IJMOK/eBus-Heating/enclosure/box-closed.png

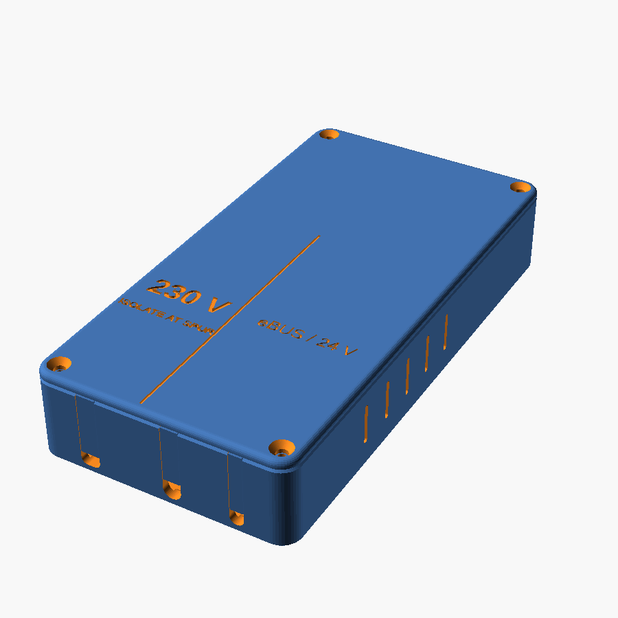
enclosure/box-closed.png
