IJMOK/eBus-Heating/enclosure/box-inside.png

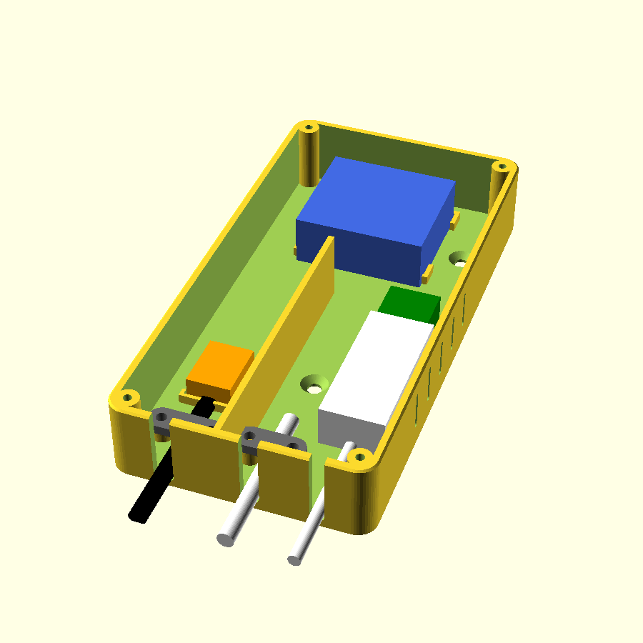
enclosure/box-inside.png
