IJMOK/eBus-Heating/enclosure/stl/clamp_mains.stl

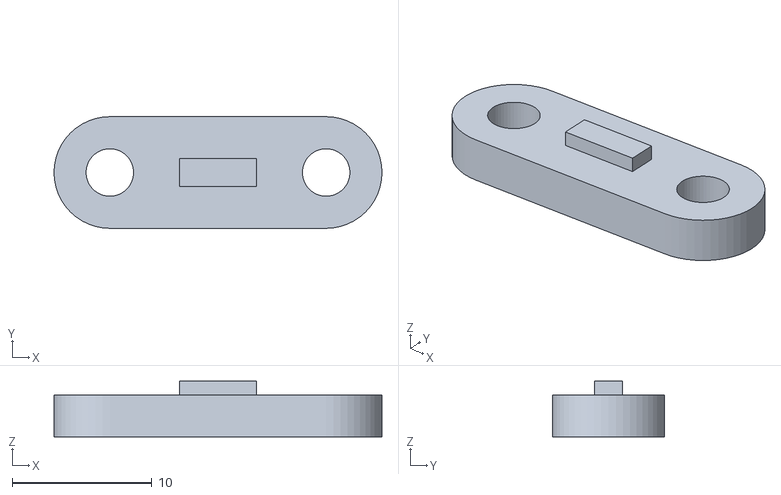
[picture p3: CAD file, 2026-10-21]
enclosure/stl/clamp_mains.stl
23.5 x 8.00 x 4.00
