IJMOK/eBus-Heating/enclosure/stl/testfit.stl

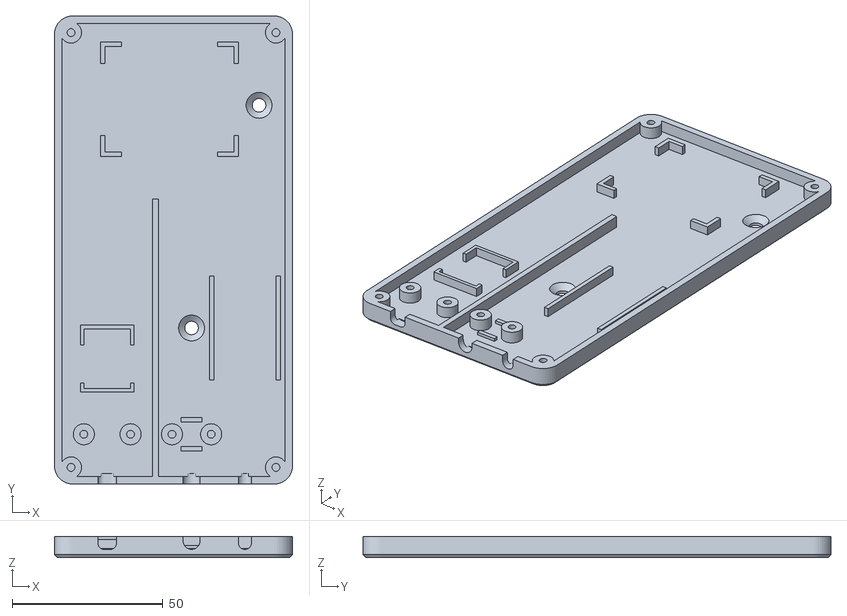
[picture p4: CAD file, 2026-10-21]
enclosure/stl/testfit.stl
79.0 x 155.3 x 7.00
