IJMOK/eBus-Heating/enclosure/stl/base.stl

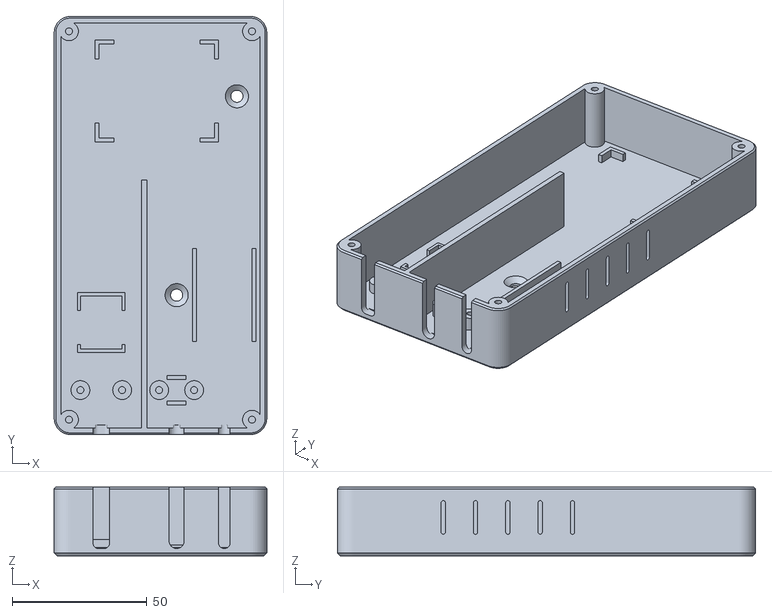
[picture p5: CAD file, 2026-10-21]
enclosure/stl/base.stl
79.0 x 155.3 x 25.5
