IJMOK/eBus-Heating/enclosure/stl/lid.stl

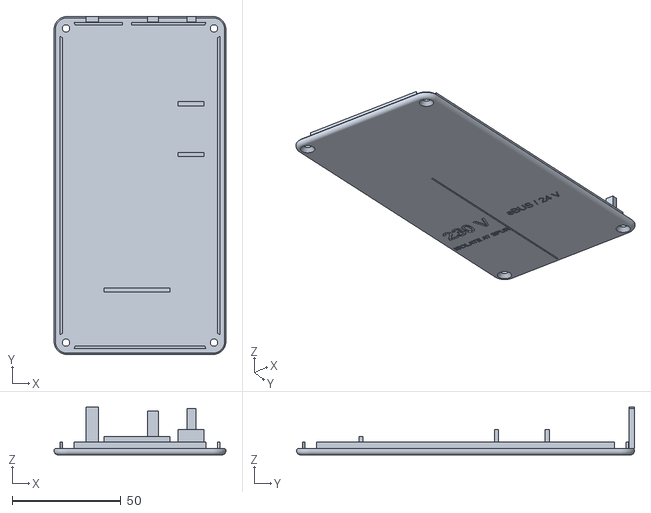
[picture p6: CAD file, 2026-10-21]
enclosure/stl/lid.stl
79.0 x 155.3 x 21.9
