IJMOK/eBus-Heating/enclosure/stl/clamp_lv.stl

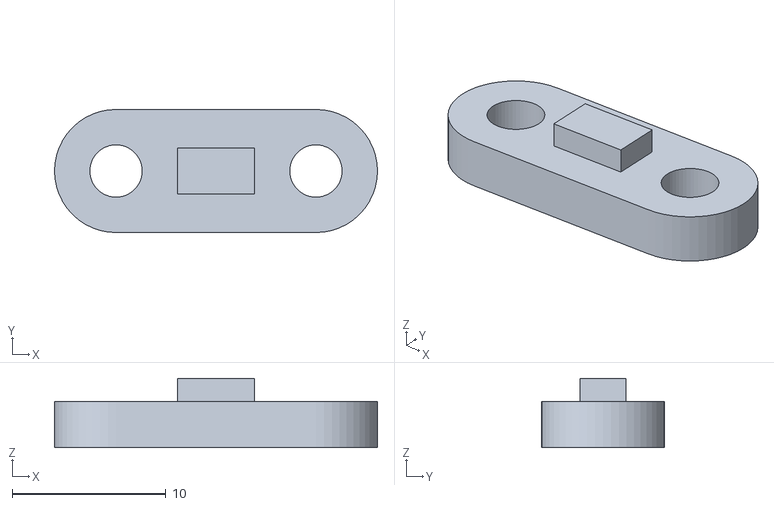
[picture p7: CAD file, 2026-10-21]
enclosure/stl/clamp_lv.stl
21.0 x 8.00 x 4.50
