IJMOK/eBus-Heating/docs/results.md

# Results

> Written during P7: stage history, comfort events, and the final learned curve.
