IJMOK/eBus-Heating/(commit log)

2026-10-16 P1 docs: eBUS stick firmware/Wi-Fi, wiring and safety, ebusd add-on setup (read-only)
2026-10-17 Helpers package, Node-RED flows (control, comfort, nightly) and dashboard: sanitised, dry-run by default
2026-10-17 Docs: hardware, Shelly failsafe, control law, staged handover, dashboard, test plan; failsafe script; heartbeat + eBUS watchdog flows
2026-10-17 Wiring: step-by-step Shelly 1 Gen4 to 24V RT, label reading, spur power
2026-10-17 Flows: unique node names
2026-10-18 Room sensor counts as stale after 90 min without a temperature or humidity update
    HA only records a reading when the value changes, so a steady room went quiet
    for 30+ minutes and looked like a dead sensor. The Shelly failsafe still
    catches a really dead sensor after 30 min.
2026-10-18 P5 failsafe test results (all 11 pass) and fixes
    - Shelly script re-publishes its mode on every MQTT (re)connect
    - Control law re-sends the relay state every 5 min
    - Button triggers accept a previous state of 'unknown'
    - Dashboard comfort tile presses the button instead of 'toggle'
    - eBUS-lost text mentions the bus-signal trigger
    [heating.yaml]
2026-10-18 Failsafe mode reaches HA without Node-RED (webhook)
    The Shelly script POSTs each mode change to an HA webhook (URL in KVS
    fs_webhook) and retries every minute until accepted. Package: webhook
    automation + one notify-on-change automation; the Node-RED mirror no longer
    notifies. Docs and PLACEHOLDERS updated.
    [heating.yaml]
2026-10-18 Heating season switch: summer off for HA and the Shelly failsafe
    [heating.yaml]
2026-10-18 ebusd: pin the definitions and give SetMode its own access level
    tools/pin-ebusd-config.py mirrors the Vaillant definitions ebusd loads and moves
    only the active SetMode write to a new level, so --accesslevel=heating unlocks
    SetMode and nothing else, even after upstream relabels. Docs updated.
2026-10-18 Control law publishes the next heating block (input_text.heating_next)
2026-10-18 Docs: current status (live at Stage 0, failsafe tested), heating season, tab 43, pinned ebusd
2026-10-20 Scheduler: day types (Work/Home/Out), a temperature per period, calendar overrides
    Each weekday picks a day type with its own times and temperature per period;
    a "Heating" calendar event titled Home/Work/Out/Off sets a single date
    (sensor.heating_calendar_days). Precedence: away > calendar > holiday at home >
    the week. Replaces heating_setpoint_day, heating_weekday_evening_start,
    heating_weekend_start and heating_period_end. Comfort mode and the away return
    use the Home temperature. Tomorrow's date no longer uses +24 h (clock changes).
    [heating.yaml]
2026-10-20 Enclosure: printable wall box for the Shelly and the stick; alarm calendar overrides
    - enclosure/: parametric OpenSCAD design (FR-ABS, mains and low-voltage
    compartments, cable clamps, tool-only lid marked 230 V), STLs and renders;
    linked from the README and the parts list.
    - Day-type overrides now come from the phones' alarm calendar: "NWD" or "Home"
    = Home day, "Off" = night temperature all day.
    [base.stl, clamp_lv.stl, clamp_mains.stl, heating-box.scad, lid.stl, testfit.stl]
2026-10-21 Enclosure: cut the lid lip back around the divider (it clashed at the bottom wall)
    [heating-box.scad, lid.stl]
2026-10-21 Enclosure: move the LV clamp clear of the divider, firmer grip (30 % squeeze, floor ridges)
    [base.stl, clamp_lv.stl, clamp_mains.stl, heating-box.scad, lid.stl, testfit.stl]
2026-10-23 Fire lit switch: no learning from fire days
2026-10-24 Heat on now / Heat off now: one-off overrides by hand, not learned from
2026-10-28 Stage 1 checkpoint: tools/setmode-check.py and what a pass looks like
    The SetMode check before the first flow write is now a script instead of a manual
    step: it sends a flow target below the panel setting, checks ebusd's decoded echo
    and the boiler's FlowTempDesired, logs flame and hot-water demand while you run a
    hot tap, then stops and times how long the boiler holds the target before going
    back to its own. Stdlib only (minimal MQTT client), password from MQTT_PASSWORD.
    Docs: the measured hold time (about 15 min on the BAI00 here, so no extra
    failsafe), FlowTempDesired as the readback, combi hot-water draws running the flow
    above the heating target, and the checkpoint results in testing.m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
